evaristocosta/thereminDigital/README.md

# Implementação de um Theremin Digital

Código utilizado durante o projeto de sistema embarcado com PCI de um Theremin digital por Lucas Costa e Rafael Albarello, usando o microprocessador ATMega328P, comumente empregado em placas Arduino Uno. 

Para correto funcionamento, dependências de código são as bibliotecas:
- [Ultrassonic](https://github.com/filipeflop/Ultrasonic);
- [toneAC](https://bitbucket.org/teckel12/arduino-toneac/wiki/Home);

O processo de desenvolvimento do projeto é descrito no relatório `.pdf` disponibilizado.
