evaristocosta/thereminDigital/RelatorioThereminDigital.pdf

Processo de Desenvolvimento e Construçao de um ˜ | Theremin

## Digital

Lucas F. P. Costa¹

, Rafael H. Albarello¹

1Engenharia de Computaçao – Universidade Tecnol ˜ | ogica Federal do Paran ´ | a (UTFPR) ´
Toledo – PR – Brasil

{lucascosta74,albarellorafael123}@gmail.com

### 1. Introduçaõ

Instrumentos musicais eletronicos ou que fazem uso de eletricidade tem sido desenvolvi- ˆ
dos ha s ´ eculos, podendo ter in ´ | ício reconhecido com o lançamento do clavecin electrique ´
(cravo eletrico) inventado por Jean-Baptiste Delaborde em 1759 [8]. Por sua vez, o There- ´ min foi descoberto em 1920, patenteado em 1928 e teve nome de acordo com seu inventor, Lev Theremin [5].
O funcionamento do Theremin e peculiar se comparado a outros eletr ´ | onicos, uma ˆ
vez que nao h ˜ | a contato f ´ | ísico direto para ser manuseado. Sua construçaõ e primordial- ´
mente analogica, e seu controle ´ | e feito atrav ´ | es de duas antenas de metal posicionadas nas ´
suas extremidades, servindo como sensores de proximidade para as maos do m ˜ | usico, que ´
operam osciladores de frequencia e amplitude (intensidade, volume), cujos sinais s ˆ | ao por ˜
fim amplificados por um alto-falante [6].

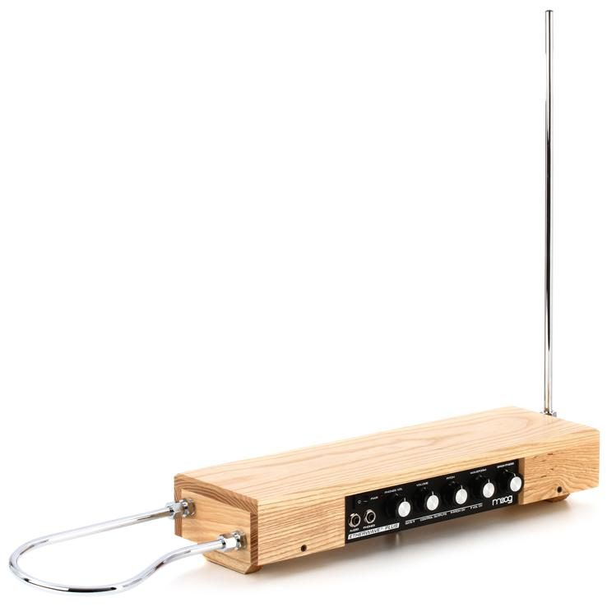
[picture p1: figure]

Figura 1. Theremin analogico comum moderno. ´

Mais recentemente, o uso de computadores pessoais e tecnicas digitais tem possi- ´
bilitado o surgimento de instrumentos de musica diferenciados com um leque de soluç ´ | oes ˜
extremamente amplo, onde as informaçoes podem ser processadas de infinitas formas e ˜
reproduzidas posteriormente. Ao inves da manipulaç ´ | ao de circuitos el ˜ | etricos, pode-se ´
lidar com dados em um grau mais elevado de detalhe, programando comportamentos diferenciados de acordo com o desejo do desenvolvedor [7].

Neste projeto, foi proposto o desenvolvimento e construçao de um Theremin uti- ˜
lizando tecnicas de processamento digital. Os dispositivos necess ´ | arios foram escolhidos ´

e um circuito funcional elaborado para a confecçao de uma Placa de Circuito Impresso ˜ (PCI) onde os componentes puderam ser conectados. Um software foi embarcado em um microcontrolador, com o suficiente para operaçao do sistema. Testes individuais fo- ˜ ram performados para cada componente, e finalmente para o sistema como um todo. O resultado foi o completo funcionamento do dispositivo, atingindo o objetivo proposto.

### 2. Materiais e Metodos ´

Para a elaboraçao deste projeto, foi preciso elencar quais seriam os dispositivos e sensores ˜
necessarios para soluç ´ | ao da proposta. Tendo isto, foi montado o esquem ˜ | atico do circuito ´
e seu equivalente para confecçao da PCI. Al ˜ | em disso, tamb ´ | em foram desenvolvidos os ´
codigos para serem embarcados e possibilitarem o correto processamento de informaç ´ | oes ˜
obtidas pela leitura dos sensores. Com a conclusao destes passos, tem-se o sistema com- ˜ pleto.

### 2.1. Escolha de Dispositivos Para o Sistema Proposto

Sao tr ˜ | es componentes principais para que seja poss ˆ | ível construir o Theremin digital, des-
critos a seguir:
- Sensores: para capturar os movimentos e distancias das m ˆ | aos do m ˜ | usico, foram ´
usados os sensores de distancia ultrass ˆ | onicos HC-SR04, em substituiç ˆ | aõ a funç ` | aõ
das antenas no Theremin analogico original. Com este sensor, ´ | e poss ´ | ível medir
distancias de 2cm a 400cm com precis ˆ | ao aproximada de 3mm [4]; ˜
- Microcontrolador: | a leitura da resposta dos sensores, processamento e
manipulaçao das informaç ˜ | oes para convers ˜ | ao em dados de ˜ | audio e por fim, a ´
reproduçao sonora podem ser feitos com uso de um microcontrolador. Neste ˜ projeto, foi utilizado o ATmega328P, comumente empregado em placas como
Arduino Uno R3 de forma destacavel[3]. Seu conversor A/D tem resoluç ´ | ao de ˜
10 bits com taxa de amostragem aproximada de 9615Hz, e usando suas saídas
PWM e poss ´ | ível gerar sinais que podem ser amplificados por um alto-falante em
frequencias e intensidades desejadas[1]. Para sua operaç ˆ | ao, ˜ | e preciso somente de ´
alimentaçao de ˜ | ±5V e a utilizaçao de um cristal oscilador de 16MHz para geraç ˜ | aõ
de clock;
- Alto-falante: para cumprir com o objetivo final de geraçao sonora, um amplifica- ˜
dor generico deve ser usado como sa ´ | ída. Este, adequadamente conectado ao mi-
crocontrolador, sera respons ´ | avel por entregar o resultado do processamento feito ´
a partir da leitura obtida dos sensores de distancia. ˆ

### 2.2. Confecçao da PCI ˜

Um dos objetivos deste projeto foi a montagem de uma PCI propria como soluç ´ | ao para ˜
o problema proposto. Dentre as diversas formas para montagem, decidiu-se pelo metodo ´ artesanal fotografico [10]. ´

Partindo de uma placa de fenolite e cobre pintada com tina fotossensível, uma
mascara com o circuito modelado para PCI ´ | e colocada sobre deixando vis ´ | íveis apenas as
partes onde se quer corroer o cobre, sendo exposta a luz ultravioleta, o que faz com que a ` tinta que estiver exposta adira a placa. Posteriormente, a placa deve ser colocada em uma `
soluçao de percloreto, realizando a corros ˜ | ao do cobre. O resultado ˜ | e a PCI, devendo-se ´
ainda perfurar nos locais indicados [10].

2.3. Logica de Implementaç ´ | aõ
A implementaçao do c ˜ | odigo para ser embarcado no microcontrolador escolhido foi feito ´
aproveitando-se da interface de desenvolvimento propria do Arduino, permitindo utili- ´ zar linguagem C, bem como todas as bibliotecas tanto nativas quanto customizadas por usuarios. ´

O codigo precisa solucionar o seguinte problema: obter valores da leitura dos ´
sensores, processa-los e reproduzir nas sa ´ | ídas de PWM. Para trabalhar com os sensores,
a biblioteca Ultrasonic [9] foi usada, tendo sido desenvolvida para trabalhar especificamente com o sensor HC-SR04 servindo como um facilitador com chamadas prontas, sem a necessidade de maiores implementaçoes. ˜
Por padrao na biblioteca do Arduino, encontra-se o utilit ˜ | ario ´ | tone() que permite
a reproduçao sonora de um tom em uma frequ ˜ | encia especificada pelo usu ˆ | ario usando ´
PWM e um alto-falante comum. Entretanto, naõ e poss ´ | ível determinar a intensidade do
som. Em soluçao a este problema, a biblioteca ˜ | toneAC permite definir tanto frequencia ˆ
como intensidade sonora, alem de melhorar a durabilidade do alto-falante e a qualidade, ´
utilizando uma estrategia de corrente alternada entre dois pinos de sa ´ | | | ída PWM [2].

### 3. Resultados

A aplicaçao da metodologia proposta retornou resultados, ap ˜ | os uma sequ ´ | encia de testes ˆ
ate chegar ao resultado final, que foi o completo funcionamento do sistema. A seguir, ´ estes sao descritos e discutidos. ˜

### 3.1. Utilizaçao da Placa Arduino Uno ˜

Objetivando testar cada elemento do circuito para determinar sua correta funcionalidade,
bem como a implementaçao de c ˜ | odigo, testes r ´ | apidos foram efetuados fazendo uso da ´
placa Arduino Uno.

O primeiro teste foi para verificar a saída obtida da leitura do sensor HC-SR04
usando a biblioteca Ultrasonic. Um rapido c ´ | odigo fora implementado e observada a sa ´ | ída
para quando o sensor era apontado para paredes e teto do espaço local e tambem para a ´
distancia da m ˆ | ao de um volunt ˜ | ario que se movimentava, averiguando o funcionamento ´
esperado.
| Depois, a funcionalidade toneAC() foi posta a prova para diferentes valo- `
res de frequencia e intensidade escolhidos manualmente. Tendo verificado seu cor- ˆ
reto comportamento, a uniao de ambos os testes resultou no c ˜ | odigo final para ser em- ´
barcado (detalhado no Apendice A), como pode ser visto ˆ | online atraves deste v ´ | ídeo:
https://youtu.be/5GCRpEJFvAo.

### 3.2. Circuito e Elaboraçao para PCI ˜

Tendo o entendimento de como deve operar o sistema e como seus componentes devem estar conectados, foi elaborado o circuito para o sistema sem a placa Arduino, ilustrado na
Figura 2. A alimentaçao se d ˜ | a pela utilizaç ´ | ao de uma bateria 9V, garantindo uma entrada ˜
CC estavel. Atendendo ao padr ´ | ao do microcontrolador, a entrada passa pelo regulador de ˜
tensao LM7805 para definir a tens ˜ | ao de entrada em 5V, necess ˜ | ario tamb ´ | em para operaç ´ | aõ
dos sensores. A configuraçao do oscilador ˜ | e de acordo com o indicado na refer ´ | encia do ˆ

ATmega328P [3]. Por fim, a conexao dos sensores e do alto-falante ˜ | e similar a quando se ´
usou o Arduino.

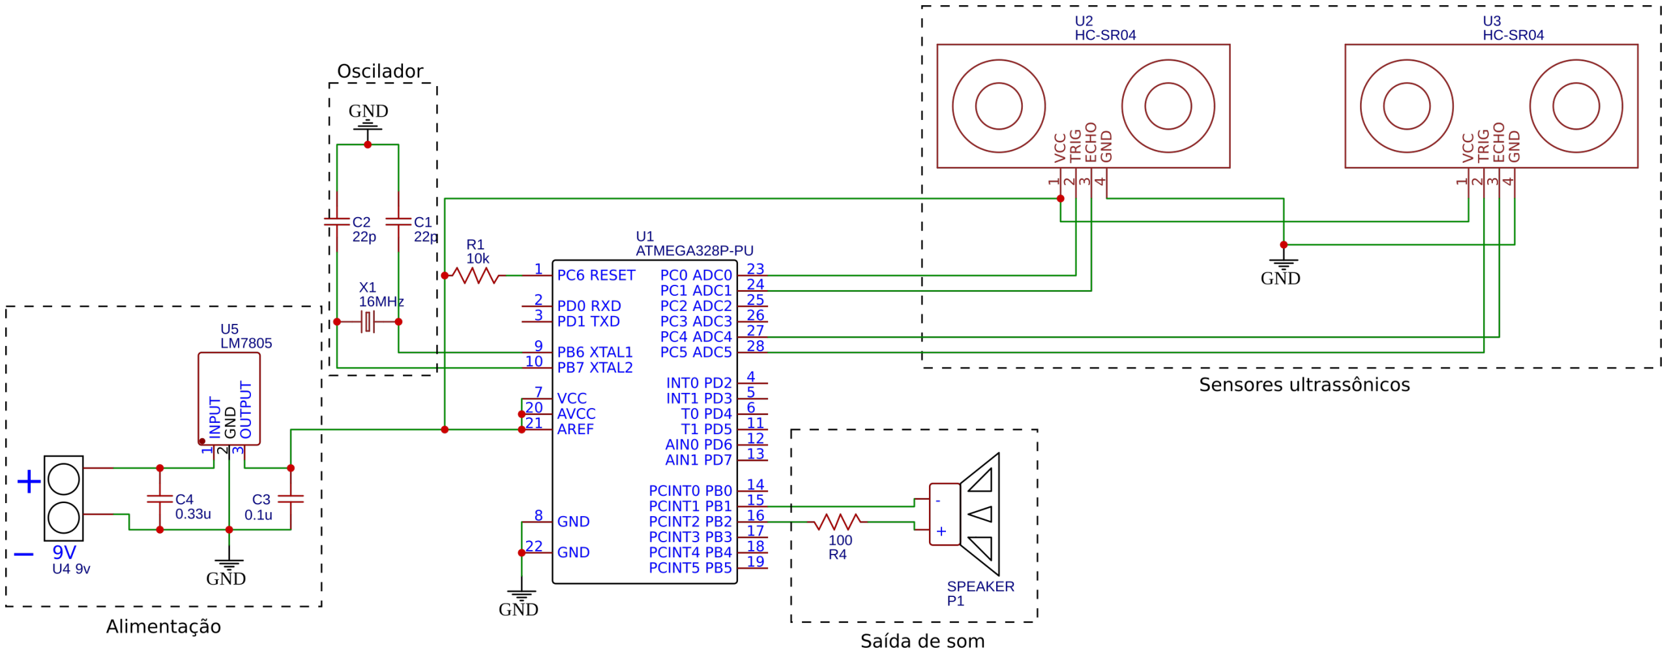
[picture p2: figure]

Figura 2. Esquematico do circuito para o Theremin digital. ´

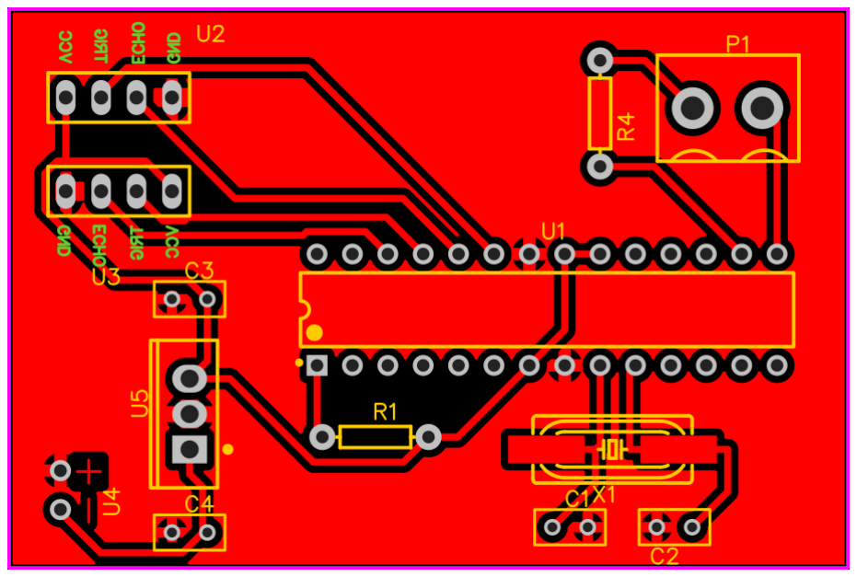
[picture p3: figure]

Figura 3. PCI resultante a partir do circuito ilustrado na Figura 2.

A partir do esquematico definido anteriormente, foi poss ´ | ível elaborar a mascara ´
para confecçao da PCI, como pode-se ver na Figura 3. A disposiç ˜ | | ao dos elementos na ˜
placa permitiu organizar o sistema de forma que cada seçao ficasse em uma de suas ex- ˜ tremidades. No canto superior esquerdo, foram posicionados os sensores de forma que um fique oposto ao outro, o que causou um problema quando definido o plano terra, deixando uma parte isolada. Este problema foi resolvido conectando-se manualmente um cabo entre ambas as referencias dos sensores (representadas por GND). No canto supe- ˆ
rior esquerdo, aparece a configuraçao para o alto-falante. Abaixo, ˜ | a esquerda, os pontos `
para alimentaçao, e ˜ | a direita, o cristal oscilador. `

### 3.3. Sistema Embarcado Funcional

Utilizando o metodo fotogr ´ | afico, foi poss ´ | ível elaborar a PCI usando a mascara anteri- ´
ormente citada (Figura 3) com qualidade razoavel, tendo por resultante o mostrado na ´ Figura 4. A colocaçao manual dos componentes foi feita com soldador e estanho comuns, ˜
tambem com resultado razo ´ | avel ilustrado na Figura 5. ´

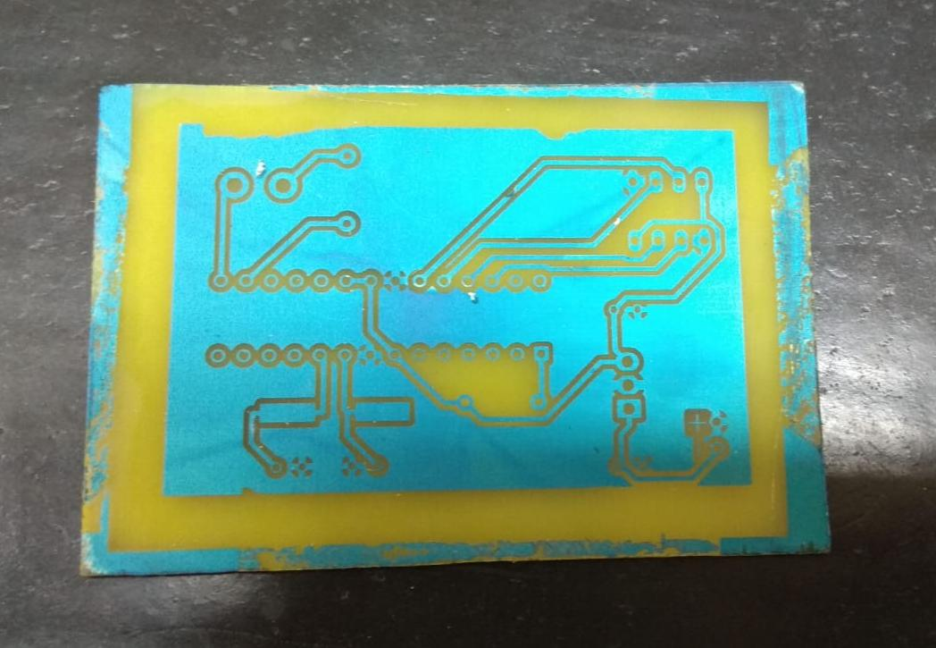
[picture p4: figure]

Figura 4. Resultado da aplicaçao do m ˜ | etodo fotogr ´ | afico para confecç ´ | ao da PCI. ˜
A gravaçao de c ˜ | odigo no microcontrolador funcionou corretamente, e a ´
alimentaçao tamb ˜ | em. No entanto n ´ | ao foi poss ˜ | ível reproduzir som a partir do alto-falante
provavelmente devido a baixa corrente provida pela bateria (aproximadamente 15mA).

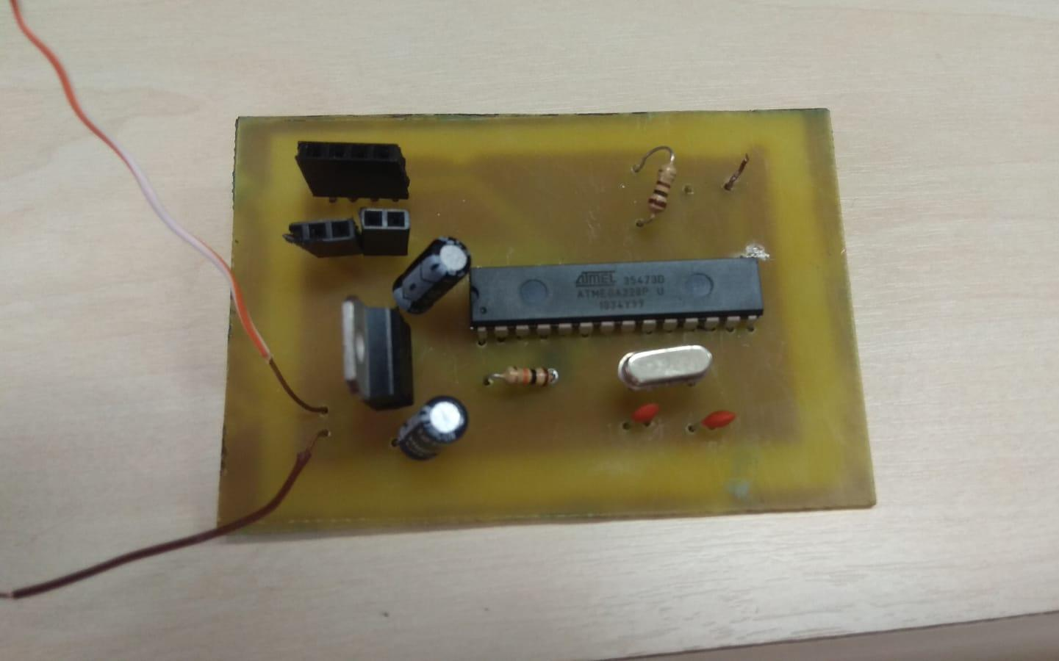
[picture p5: figure]

Figura 5. Sistema embarcado final com componentes soldados.

### 4. Conclusaõ

A proposta de desenvolvimento de um Theremin digital foi estabelecida, bem como a metodologia para tal, que foi aplicada resultando em um sistema embarcado. Uma PCI foi confeccionada artesanalmente com base em um circuito projetado, e o codigo para ´ funcionamento do sistema foi desenvolvido. Embora o sistema nao tenha funcionado ˜ de fato devido a pormenores, testes com a placa Arduino Uno confirmaram o correto comportamento conforme esperado. Como proposta de alteraçao e melhoria, poderia ter- ˜ se usado como alimentaçao uma fonte com maior capacidade de corrente, uma vez que a ˜
tensao era naturalmente regulada graças a implementaç ˜ | ao do circuito. Al ˜ | em disso, outros ´
metodos podem ser aplicados para a confecç ´ | ao da PCI, desde projeto de m ˜ | ascara at ´ | é
metodos artesanais ou industriais. ´

Referencias ˆ

[1] ATMEL. 8-bit Microcontroller with 4/8/16/32K Bytes In-System Programmable Flash, fev. 2009.
[2] T. Eckel. toneAC Arduino Library for Arduino. Disponível em https://
bitbucket.org/teckel12/arduino-toneac/wiki/Home. Acesso em 20 out. 2019.
[3] FEC. Arduino Uno R3. Disponível em https://www.fecegypt.com/
uploads/dataSheet/1522237550_arduino%20uno%20r3.pdf. (https://www.fecegypt.com/uploads/dataSheet/1522237550_arduino%20uno%20r3.pdf) Acesso em 30 nov. 2019.
[4] E. Freaks. | Ultrasonic Ranging Module HC-SR04. | Disponível em
https://cdn.sparkfun.com/datasheets/Sensors/Proximity/HCSR04.pdf. (https://cdn.sparkfun.com/datasheets/Sensors/Proximity/HCSR04.pdf) Acesso em 30 nov. 2019.
[5] A. Glinsky, B. Moog, and R. Moog. Theremin: Ether Music and Espionage. Music in American life. University of Illinois Press, 2000.
[6] T. | Holmes | and | S. | Martin. | The | ’Theremin’ | or | ’Theremin-
vox’, | out. | 2015. | Disponível | em | http://120years.net/
the-thereminleon-termensoviet-union1922/. (http://120years.net/the-thereminleon-termensoviet-union1922/) | Acesso | em | 30
nov. 2019.
[7] ISI-TICs. Instrumentos Musicais Digitais, jan. 2019. Disponível em https://
isitics.com/2019/01/15/instrumentos-musicais-digitais/. Acesso em 30 nov. 2019.
[8] I. Kipnis. The Harpsichord and Clavichord: An Encyclopedia. Encyclopedia of Keyboard Instruments. Taylor & Francis, 2013.
[9] C. Nobile. Ultrasonic.h - Library for HC-SR04 Ultrasonic Sensing Mo-
dule. Disponível em https://github.com/filipeflop/Ultrasonic/blob/master/Ultrasonic.h. (https://github.com/filipeflop/Ultrasonic/blob/master/Ultrasonic.h) Acesso em 20 out. 2019.
[10] T. P. Vendruscolo. Projeto e fabricaçao de placas de circuitos impressos ˜ | . Univer-
sidade Tecnologica Federal do Paran ´ | a, out. 2019. ´

A. Codigo Embarcado no Microcontrolador ´

O codigo implementado para ser embarcado no microcontrolador ATmega328 pode ser ´ conferido na íntegra a seguir, implementado usando linguagem C.

1 | //Carrega as bibliotecas de sensor ultrassonico e toneAC
2 | #include "Ultrasonic.h"
3 | #include "toneAC.h"

4
5 | //Define os pinos para trigger e echo
6 | int pino_trigger1 = A0;
7 | int pino_echo1 = A1;
8 | int pino_trigger2 = A5;
9 | int pino_echo2 = A4;

10
11 | //Inicializa os sensores nos pinos definidos acima
12 | Ultrasonic ultrasonic1(pino_trigger1, pino_echo1);
13 | Ultrasonic ultrasonic2(pino_trigger2, pino_echo2);

14
15 void setup() {}

16
17 | void loop() {
18 | //Le as informacoes dos sensores em cm
19 | float cm1, cm2, nota, intensidade;
20 | long microsec1 = ultrasonic1.timing();
21 | long microsec2 = ultrasonic2.timing();
22 | cm1 = ultrasonic1.convert(microsec1, Ultrasonic::CM);
23 | cmc2 = ultrasonic2.convert(microsec2, Ultrasonic::CM);

24
25 | // Mapeia a leitura dos sensores entre 5cm e 30cm
26 | // Notas vao de La2 ate La4 (2 oitavas)
27 | nota = map(cm1, 5, 30, 220, 880);
28 | // Intensidade varia entre minino e maximo possivel
29 | intensidade = map(cm2, 5, 30, 1, 10);

30
31 | toneAC(nota, intensidade);
32 | }
