evaristocosta/thereminDigital/(commit log)

2020-01-07 adicao de arquivos
2020-01-07 correcoes de autoria
